thkaratsis/Mitsos----An-Open-Source-AI-Humanoid-Robot/README.md

**This repository will showcase the development of a small Ai Humanoid Robot**
