thkaratsis/Mitsos----An-Open-Source-AI-Humanoid-Robot/schemes/Readme.md

# Folder Overview

| Folder | Description |
|---|---|
| **Power Management** | Battery pack, BMS, fuse, power switch, voltage regulators, and power distribution throughout the robot. |
| **Controllers** | Raspberry Pi 5, ESP32-S3, processor communication, and overall system architecture. |
| **Sensors - Main Body** | IMU, Time-of-Flight sensors, PCA9685 servo controllers, camera interface, and communication buses located in the robot's main body. |
| **Sensors - Head** | Head electronics including the TFT display, MEMS microphone, audio amplifier, ribbon cable interface, and camera ring light connection. |
| **Camera RingLight** | Dedicated LED illumination PCB mounted around the camera to provide consistent lighting for computer vision tasks. |

# Documentation

Every hardware subfolder includes:

- Electrical schematic
- Hardware overview
- Communication architecture
- Component specifications
- Design considerations
- Mermaid block diagrams
