thkaratsis/Mitsos----An-Open-Source-AI-Humanoid-Robot/models/Legs/README.md

## Leg STL Files

| Part | Role | Material | File |
|---|---|---|---|
| FootBase2.1 | Outer foot base that screws onto the foot core and increases traction. | TPU | [FootBase2.1.stl](./FootBase2.1.stl) |
| FootCore1.1 | Main foot structure with holes for connecting the rest of the leg assembly. | PETG | [FootCore1.1.stl](./FootCore1.1.stl) |
| FootScrewBase1.2 | Weighted foot base with built-in screw mounts for up to 12 M20 nuts, lowering the center of mass. | PETG | [FootScrewBase1.2.stl](./FootScrewBase1.2.stl) |
| Gear-joint | Connects Leg2 to Leg1 and screws into a 25T servo horn for knee motion. | PETG | [Gear-joint.stl](./Gear-joint.stl) |
| Knee-AnkleBracket | Bracket that connects the knee/ankle servo assembly into the foot core. | ASA | [Knee-AnkleBracket.stl](./Knee-AnkleBracket.stl) |
| Leg1 | Base for the knee and ankle assembly, connects to the hip servo at the top. | PETG | [Leg1.stl](./Leg1.stl) |
| Leg2 | Base for the ankle servo. | PETG | [Leg2.stl](./Leg2.stl) |
| LegJointConnectors | Cylindrical connectors that hold the leg structure together and define the knee motion range.. | PETG | [LegJointConnectors.stl](./LegJointConnectors.stl) |
| LegJointStabilizer4 | Spring-loaded stabilizers used on both legs to keep the legs straight and prevent bending outward. | PETG | [LegJointStabilizer4.stl](./LegJointStabilizer4.stl) |
| LegMount | Bracket that holds the hip servo and connects the pelvis servo to the full leg assembly. | ASA | [LegMount.stl](./LegMount.stl) |
