thkaratsis/Mitsos----An-Open-Source-AI-Humanoid-Robot/models/Body/README.md

## Body STL Files

| Part | Role | Material | File |
|---|---|---|---|
| Body1.2 | Connects the head and shoulder servos | ASA | [Body1.2.stl](./Body1.2.stl) |
| Body2.1 | Rear connector between Body1.2 and Body3.3; holds the back TOF on the outside | PETG | [Body2.1.stl](./Body2.1.stl) |
| Body3.3 | Connects the pelvis servos and provides screw mounts for the main electronics board | PETG | [Body3.3.stl](./Body3.3.stl) |
| Body4.3 | Main structural body part, connects to all other body parts and holds the electronics, accessories, and front ToF sensors | PETG | [Body4.3.stl](./Body4.3.stl) |
| Body5.1 | Decorative cover part that screws over Body3.3 | PETG | [Body5.1.stl](./Body5.1.stl) |
| Body6.1 | Top body section that screws onto Body1.2, connects to the head, and includes a hole for the camera CSI cable | ASA | [Body6.1.stl](./Body6.1.stl) |
| BodyPiBase | Mounting base for the Raspberry Pi | ASA | [BodyPiBase.stl](./BodyPiBase.stl) |
| BodyTofBase | Mounting base for the front ToF sensors | PETG | [BodyTofBase.stl](./BodyTofBase.stl) |
| BodyV4Aceesss3 | Accessory that allow the user to effortlessly change the batteries | PETG | [BodyV4Aceesss3.stl](./BodyV4Aceesss3.stl) |
