thkaratsis/Mitsos----An-Open-Source-AI-Humanoid-Robot/schemes/Controllers/README.md

# Controllers 

<p align="center">
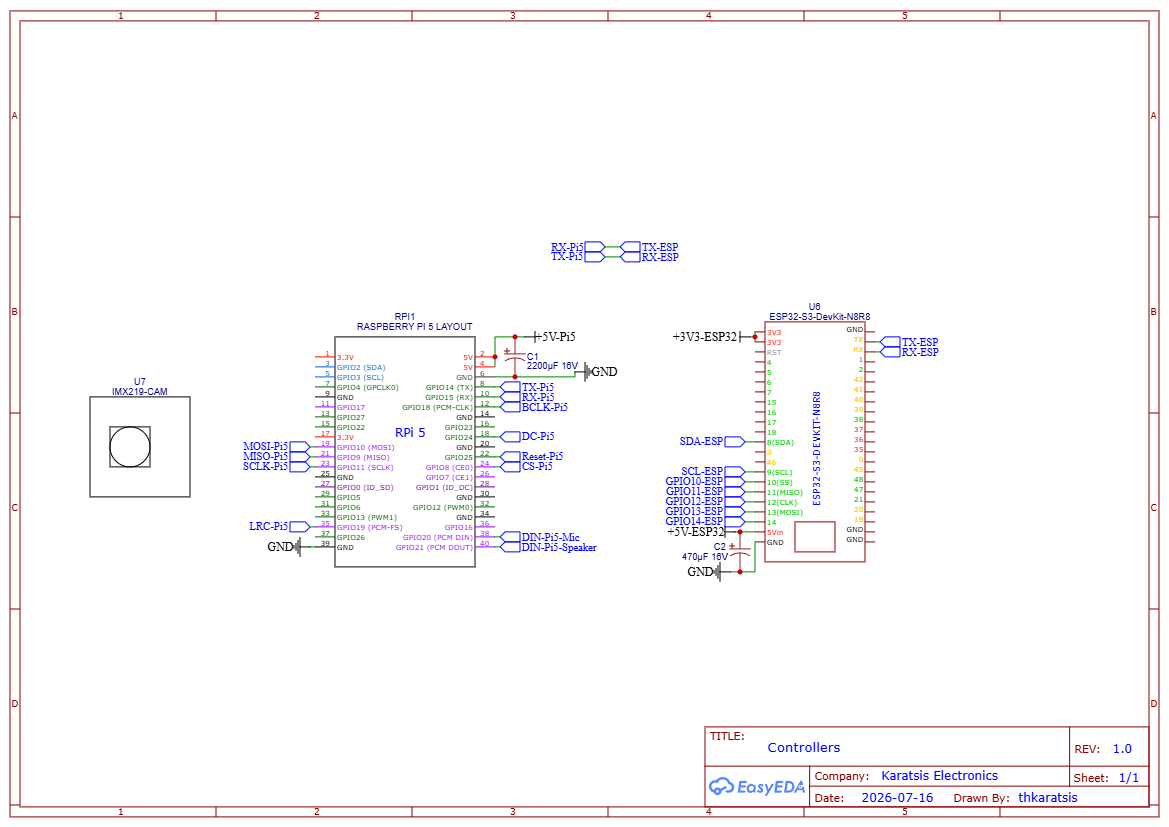
[picture p8: schemes/Controllers/Controllers.png]
  
</p>

<p align="center">
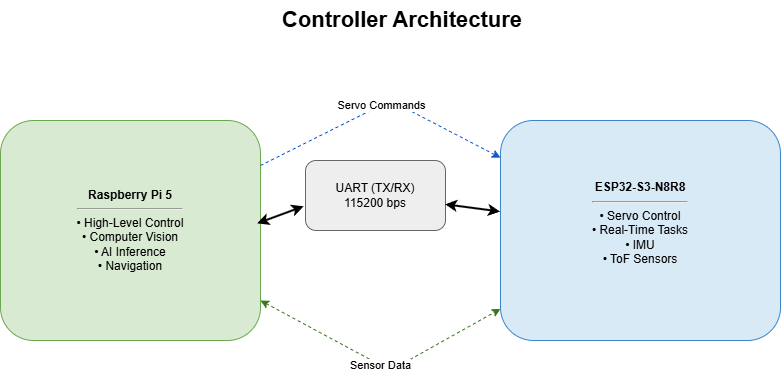
[picture p9: schemes/Controllers/Controllers_Diagram.drawio.png]
  
</p>

The robot's main controller is the **Raspberry Pi 5**, a powerful single-board computer (SBC) responsible for high-level control, computer vision, and AI inference. An **ESP32-S3-N8R8** microcontroller is used alongside the Raspberry Pi to accurate controll and gather data from all of the sensors.

To ensure reliable communication between the two processing units, the **Raspberry Pi 5** and the **ESP32-S3-N8R8** exchange data over a **full-duplex UART interface**. This bidirectional communication enables simultaneous transmission and reception of commands and sensor data.

The **Raspberry Pi 5** performs the high-level control tasks, generating servo commands and transmitting them to the ESP32. The **ESP32**, acting as the real-time controller, executes these commands while continuously collecting data from all onboard sensors and transmitting the measurements back to the Raspberry Pi.This set up allows the Raspberry Pi to focus on AI and navigation while the ESP32 handles real-time hardware interaction.

## Raspberry Pi 5

| Specification | Value |
|---|---|
| Processor | Broadcom BCM2712 |
| CPU Architecture | 64-bit Arm Cortex-A76 |
| CPU Cores | 4 |
| CPU Frequency | Up to 2.4 GHz |
| Memory | 16 GB LPDDR4X SDRAM |
| GPU | VideoCore VII |
| AI Acceleration | Software (CPU/GPU) |
| Storage | microSD Card |
| Wireless | Wi-Fi 802.11ac, Bluetooth 5.0 BLE |
| Ethernet | Gigabit Ethernet |
| USB | 2 × USB 3.0, 2 × USB 2.0 |
| Camera Interface | 2 × MIPI CSI |
| Display Interface | 2 × MIPI DSI |
| GPIO | 40-pin Header |
| UART | Yes |
| Operating Voltage | 5 V DC |
| Typical Power Consumption | 3–12 W | 

## ESP32-S3-N8R8

| Specification | Value |
|---|---|
| Processor | Xtensa® LX7 Dual-Core |
| CPU Frequency | Up to 240 MHz |
| CPU Cores | 2 |
| SRAM | 512 KB |
| Flash Memory | 8 MB |
| PSRAM | 8 MB |
| Wi-Fi | 2.4 GHz IEEE 802.11 b/g/n |
| Bluetooth | Bluetooth 5 LE |
| GPIO | Up to 45 |
| ADC | 20 Channels (12-bit) |
| SPI | Yes |
| I²C | Yes |
| UART | 3 Controllers |
| PWM | LEDC PWM |
| USB | Native USB OTG |
| Operating Voltage | 3.0–3.6 V |
| Typical Current Consumption | ~80–240 mA (application dependent) |
