thkaratsis/Mitsos----An-Open-Source-AI-Humanoid-Robot/Mechanical Analysis/COM - Center Of Mass/FrontView.png

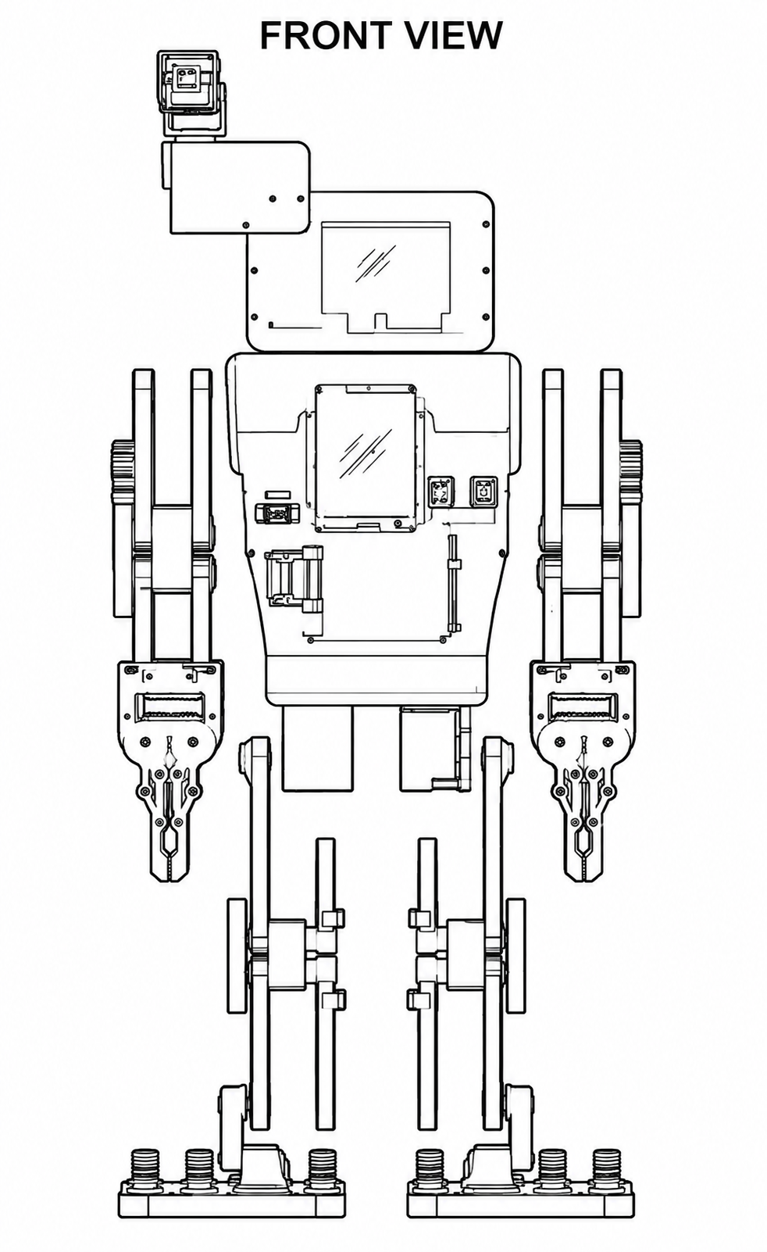
Mechanical Analysis/COM - Center Of Mass/FrontView.png
