thkaratsis/Mitsos----An-Open-Source-AI-Humanoid-Robot/models/ArmFull.stl

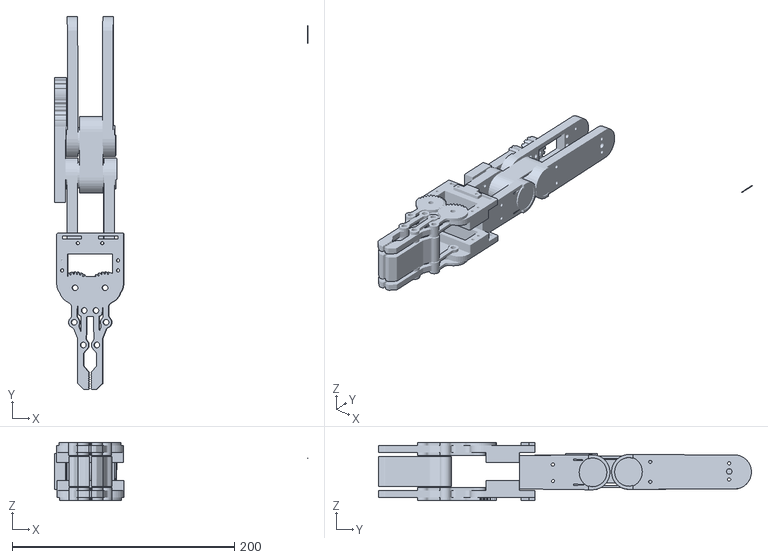
[picture p12: CAD file, 2026-07-18]
models/ArmFull.stl
227.7 x 335.5 x 52.4
