thkaratsis/Mitsos----An-Open-Source-AI-Humanoid-Robot/models/HeadFull.stl

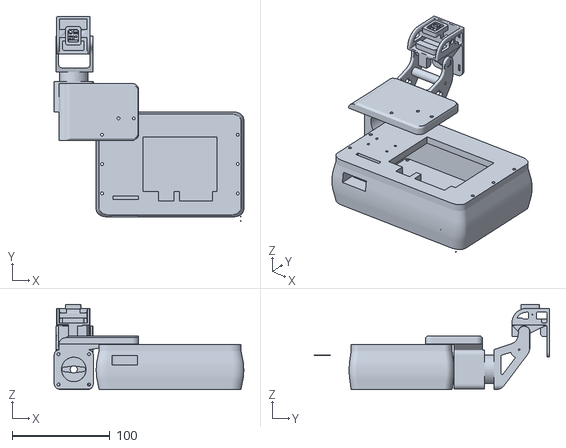
[picture p13: CAD file, 2026-07-18]
models/HeadFull.stl
193.9 x 240.4 x 87.0
