thkaratsis/Mitsos----An-Open-Source-AI-Humanoid-Robot/models/Arms/ServoGripperGear.stl

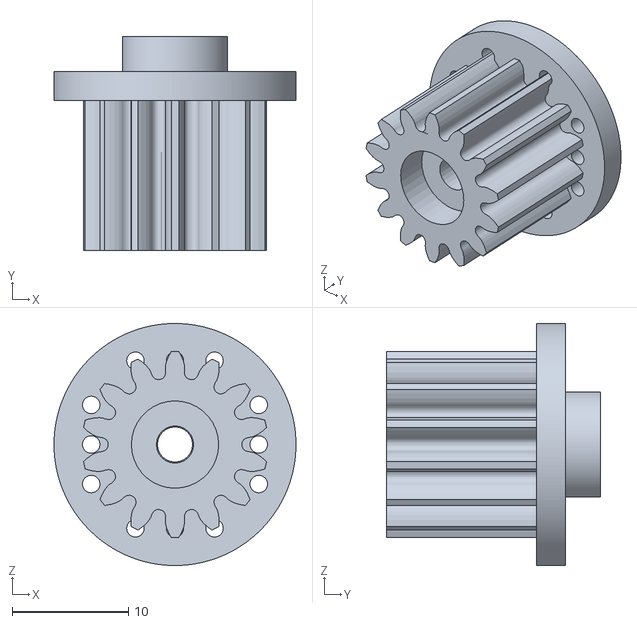
[picture p14: CAD file, 2026-07-18]
models/Arms/ServoGripperGear.stl
20.8 x 18.4 x 20.8
