thkaratsis/Mitsos----An-Open-Source-AI-Humanoid-Robot/models/Body/Body1.2.stl

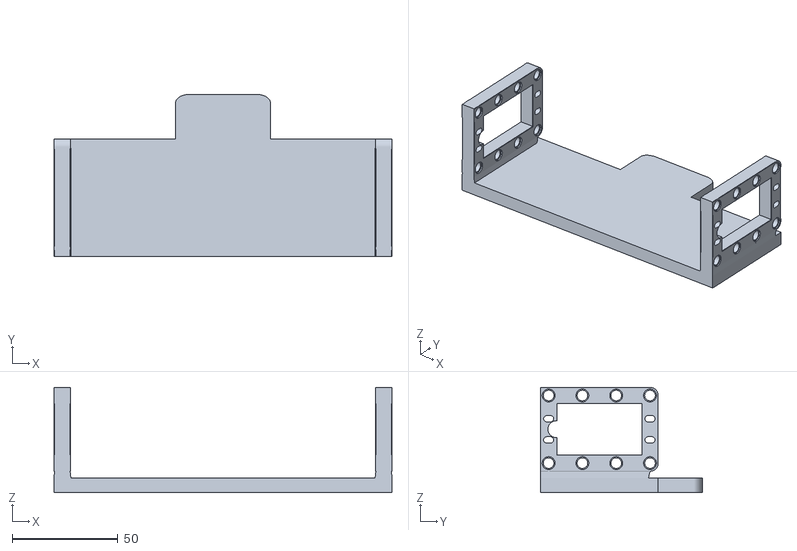
[picture p15: CAD file, 2026-07-18]
models/Body/Body1.2.stl
160.0 x 76.8 x 49.9
