thkaratsis/Mitsos----An-Open-Source-AI-Humanoid-Robot/models/Head/Head5.stl

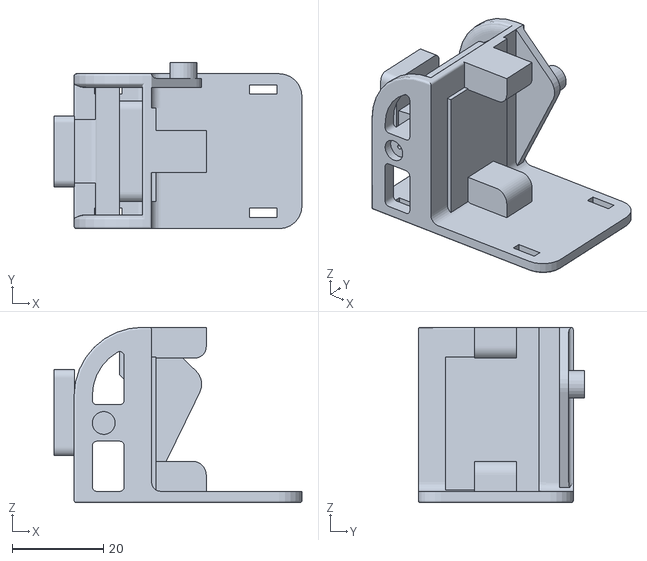
[picture p16: CAD file, 2026-07-18]
models/Head/Head5.stl
54.4 x 36.5 x 38.5
