thkaratsis/Mitsos----An-Open-Source-AI-Humanoid-Robot/models/Legs/Gear-joint.stl

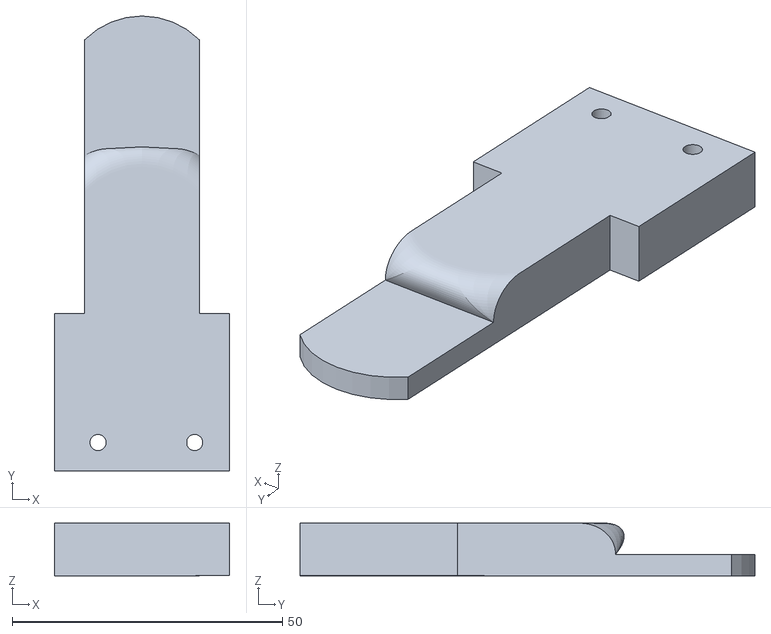
[picture p17: CAD file, 2026-07-18]
models/Legs/Gear-joint.stl
32.5 x 84.2 x 9.76
