thkaratsis/Mitsos----An-Open-Source-AI-Humanoid-Robot/models/Arms/Arm1.stl

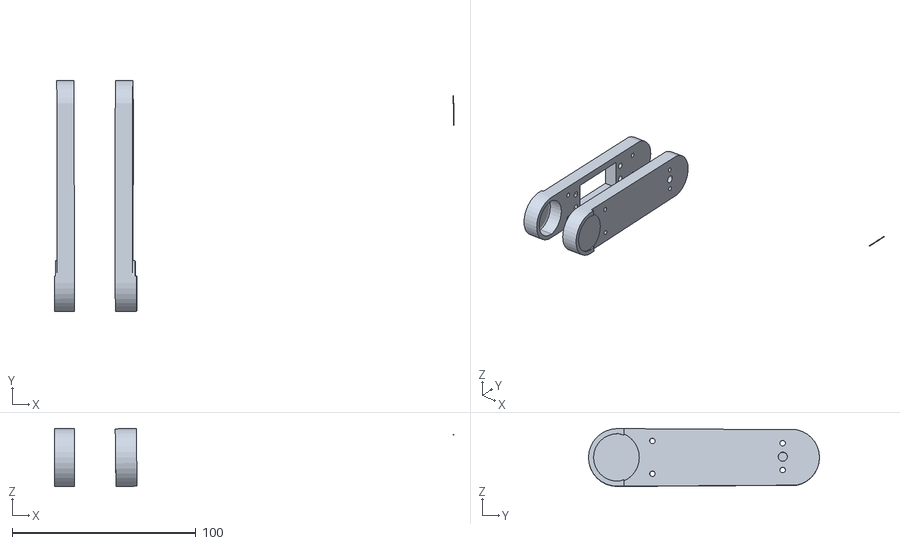
[picture p18: CAD file, 2026-07-18]
models/Arms/Arm1.stl
217.4 x 125.9 x 31.6
