thkaratsis/Mitsos----An-Open-Source-AI-Humanoid-Robot/models/Body/Body3.3.stl

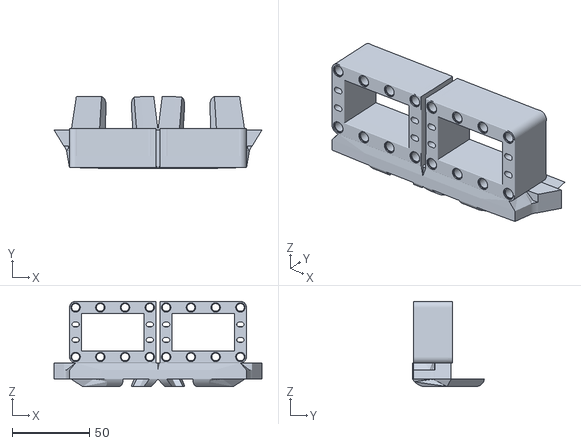
[picture p19: CAD file, 2026-07-18]
models/Body/Body3.3.stl
134.5 x 46.3 x 55.2
