thkaratsis/Mitsos----An-Open-Source-AI-Humanoid-Robot/models/Head/Head6.stl

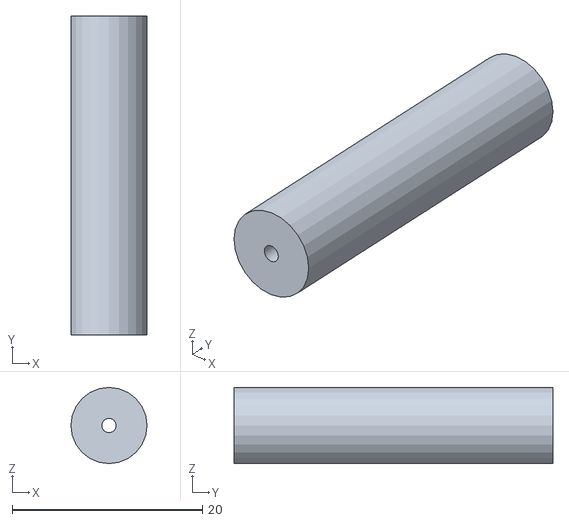
[picture p20: CAD file, 2026-07-18]
models/Head/Head6.stl
8.00 x 33.5 x 8.00
