thkaratsis/Mitsos----An-Open-Source-AI-Humanoid-Robot/models/Legs/FootCore1.1.stl

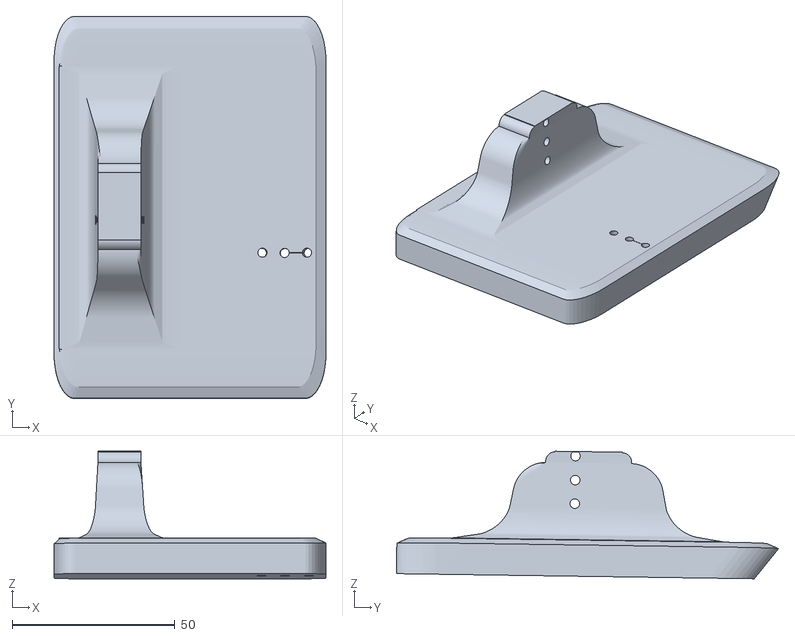
[picture p21: CAD file, 2026-07-18]
models/Legs/FootCore1.1.stl
83.6 x 117.5 x 39.2
