thkaratsis/Mitsos----An-Open-Source-AI-Humanoid-Robot/models/Arms/Arm2.stl

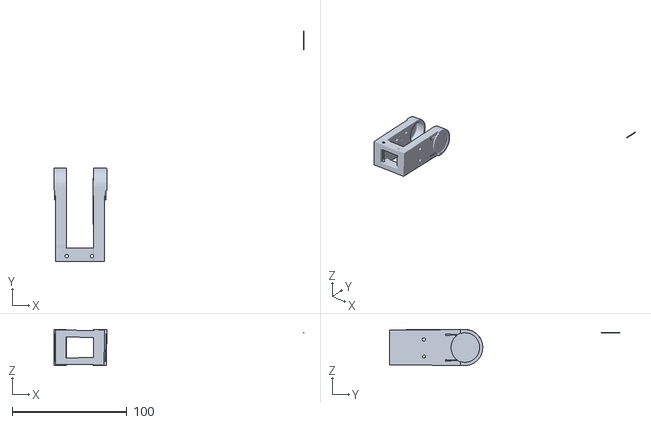
[picture p22: CAD file, 2026-07-18]
models/Arms/Arm2.stl
217.5 x 200.5 x 31.6
