thkaratsis/Mitsos----An-Open-Source-AI-Humanoid-Robot/models/Body/Body6.1.stl

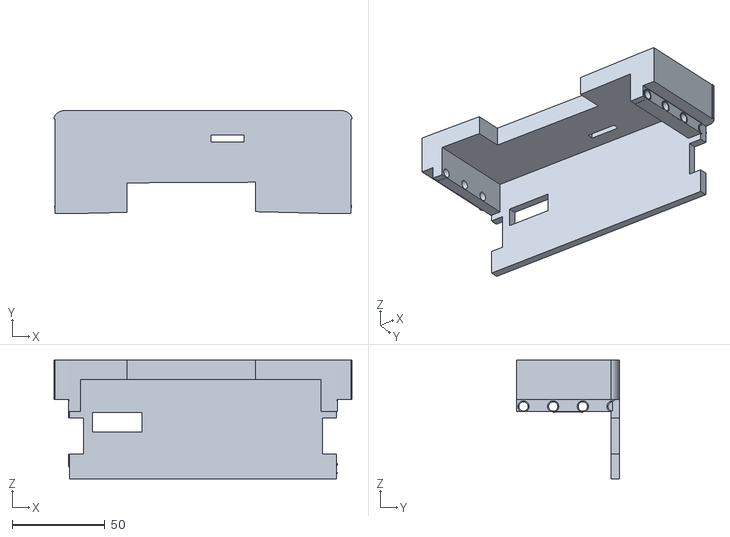
[picture p23: CAD file, 2026-07-18]
models/Body/Body6.1.stl
160.6 x 55.8 x 64.0
