thkaratsis/Mitsos----An-Open-Source-AI-Humanoid-Robot/models/Head/Head2.stl

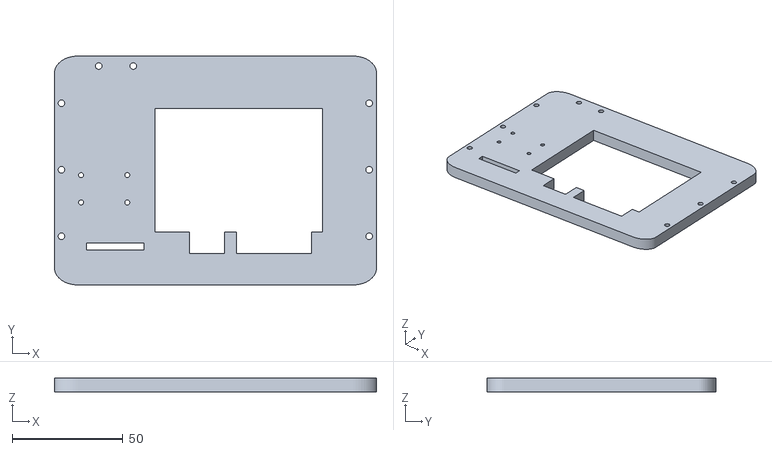
[picture p24: CAD file, 2026-07-18]
models/Head/Head2.stl
145.2 x 103.3 x 6.47
