thkaratsis/Mitsos----An-Open-Source-AI-Humanoid-Robot/models/Arms/ArmGripper.stl

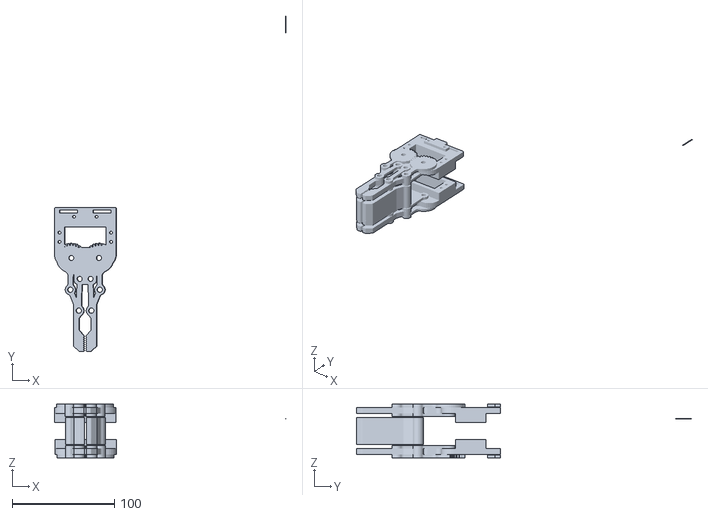
[picture p25: CAD file, 2026-07-18]
models/Arms/ArmGripper.stl
225.4 x 327.3 x 52.4
