thkaratsis/Mitsos----An-Open-Source-AI-Humanoid-Robot/models/Body/Body4.3.stl

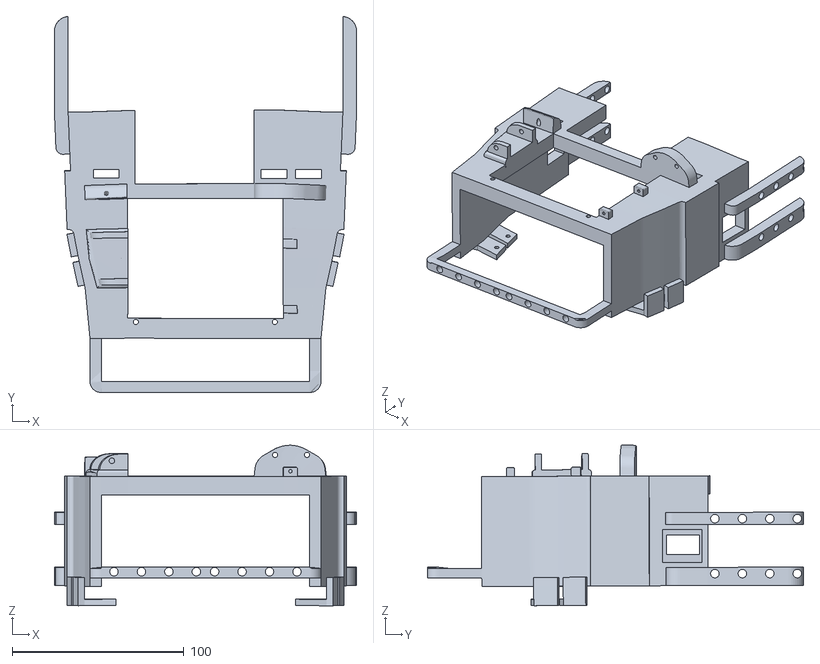
[picture p26: CAD file, 2026-07-18]
models/Body/Body4.3.stl
175.9 x 218.9 x 93.5
