thkaratsis/Mitsos----An-Open-Source-AI-Humanoid-Robot/models/Head/Head1.stl

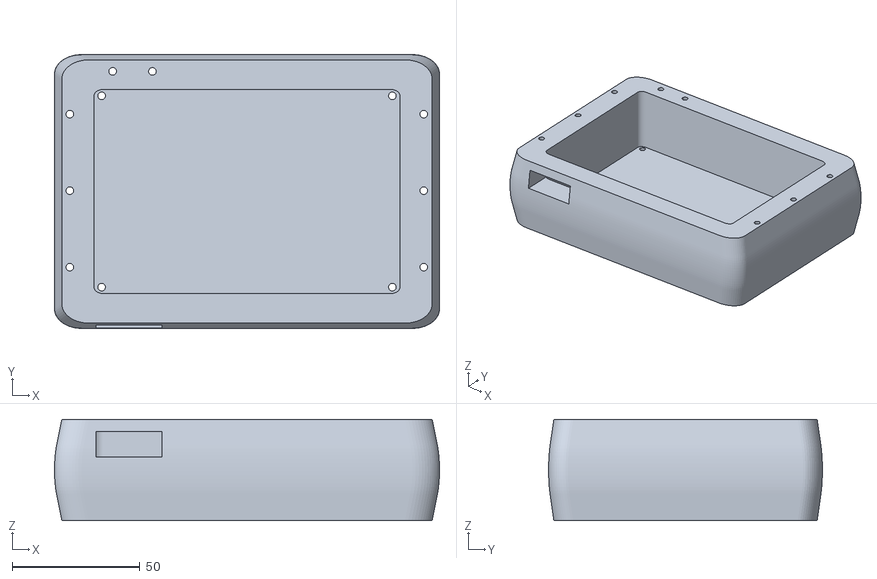
[picture p27: CAD file, 2026-07-18]
models/Head/Head1.stl
151.0 x 107.3 x 39.7
