thkaratsis/Mitsos----An-Open-Source-AI-Humanoid-Robot/models/Legs/LegJointStabilizer4.stl

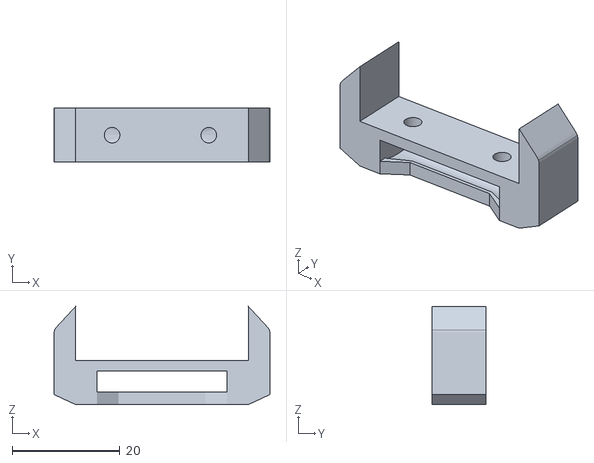
[picture p28: CAD file, 2026-07-18]
models/Legs/LegJointStabilizer4.stl
40.0 x 10.0 x 18.2
