thkaratsis/Mitsos----An-Open-Source-AI-Humanoid-Robot/models/Arms/ArmGears.stl

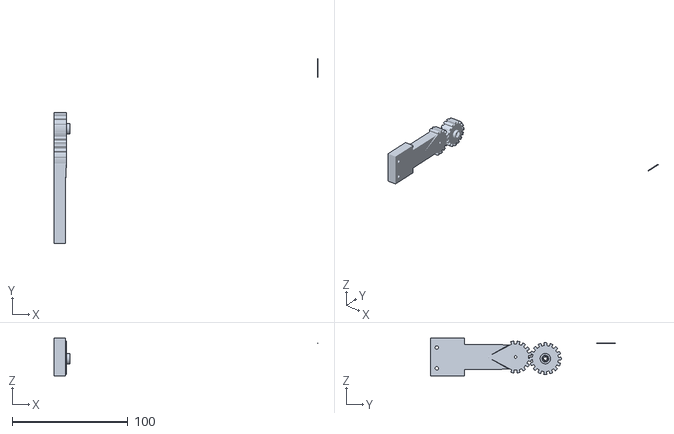
[picture p29: CAD file, 2026-07-18]
models/Arms/ArmGears.stl
227.7 x 159.2 x 32.5
