thkaratsis/Mitsos----An-Open-Source-AI-Humanoid-Robot/models/Body/BodyTofBase.stl

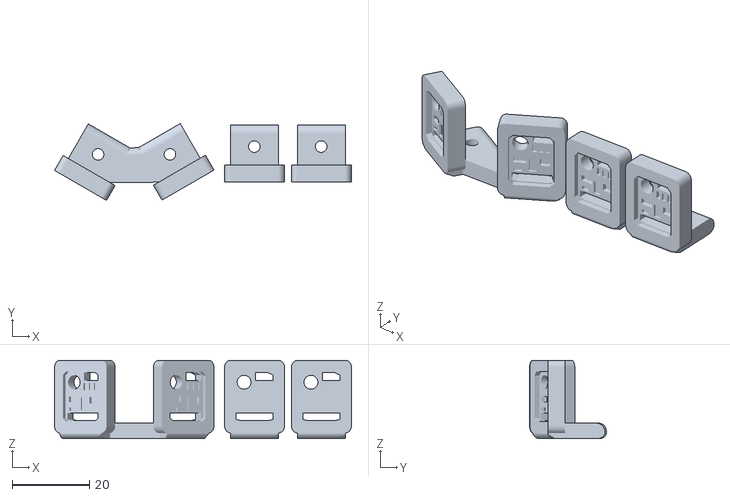
[picture p30: CAD file, 2026-07-18]
models/Body/BodyTofBase.stl
76.9 x 19.9 x 20.3
