thkaratsis/Mitsos----An-Open-Source-AI-Humanoid-Robot/models/Head/Head3.stl

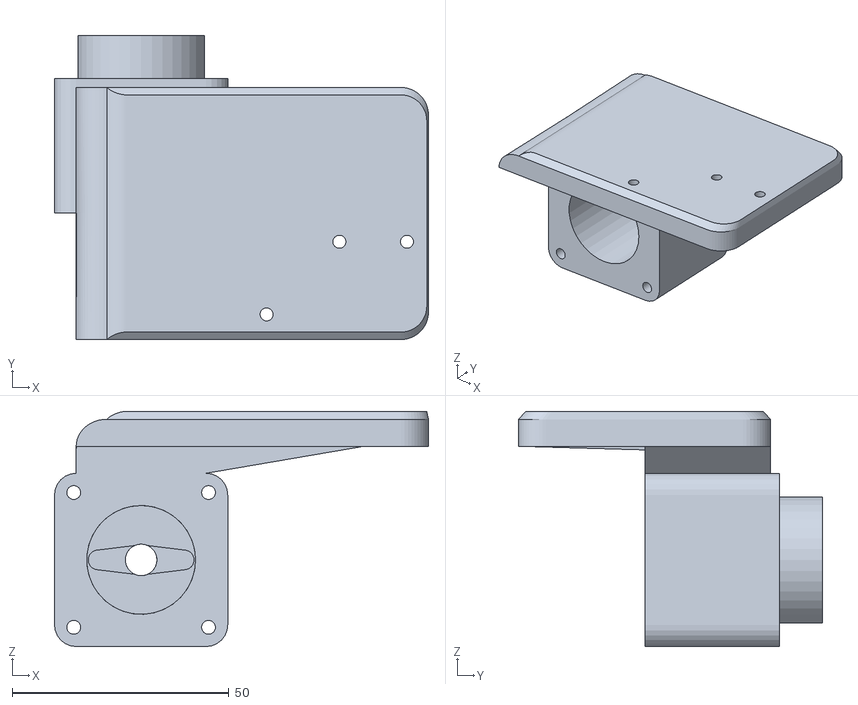
[picture p31: CAD file, 2026-07-18]
models/Head/Head3.stl
86.3 x 70.2 x 54.3
