thkaratsis/Mitsos----An-Open-Source-AI-Humanoid-Robot/models/Legs/Knee-AnkleBracket.stl

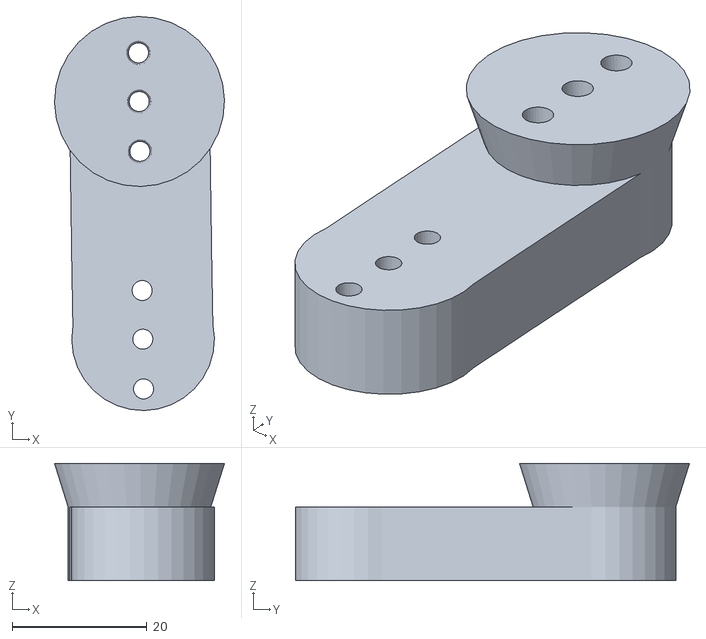
[picture p32: CAD file, 2026-07-18]
models/Legs/Knee-AnkleBracket.stl
25.2 x 58.5 x 17.4
