thkaratsis/Mitsos----An-Open-Source-AI-Humanoid-Robot/models/Body/BodyV4Aceesss3.stl

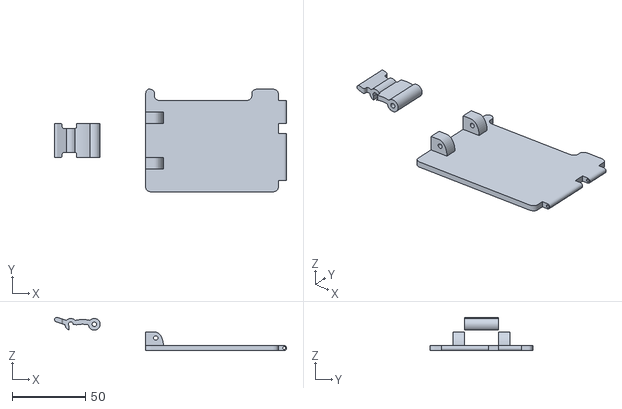
[picture p33: CAD file, 2026-07-18]
models/Body/BodyV4Aceesss3.stl
157.8 x 69.9 x 22.8
