thkaratsis/Mitsos----An-Open-Source-AI-Humanoid-Robot/models/Head/Head4.stl

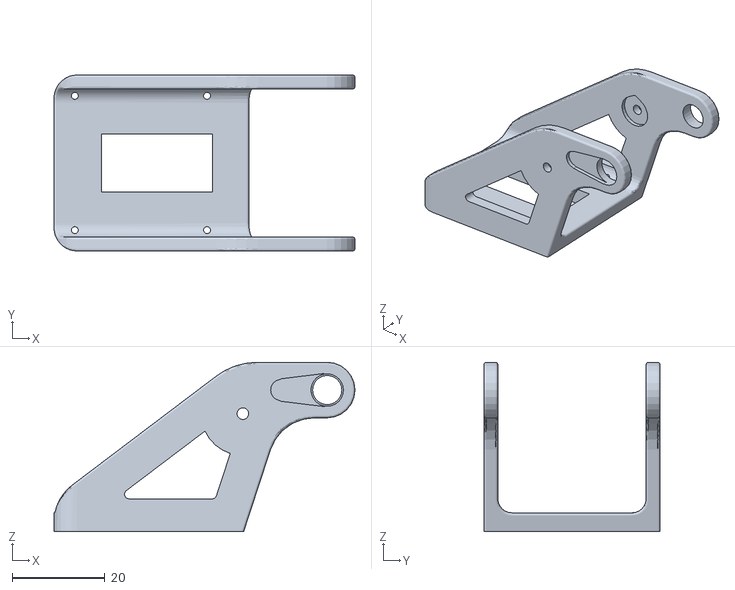
[picture p34: CAD file, 2026-07-18]
models/Head/Head4.stl
65.0 x 38.0 x 36.6
