thkaratsis/Mitsos----An-Open-Source-AI-Humanoid-Robot/models/Legs/Leg1.stl

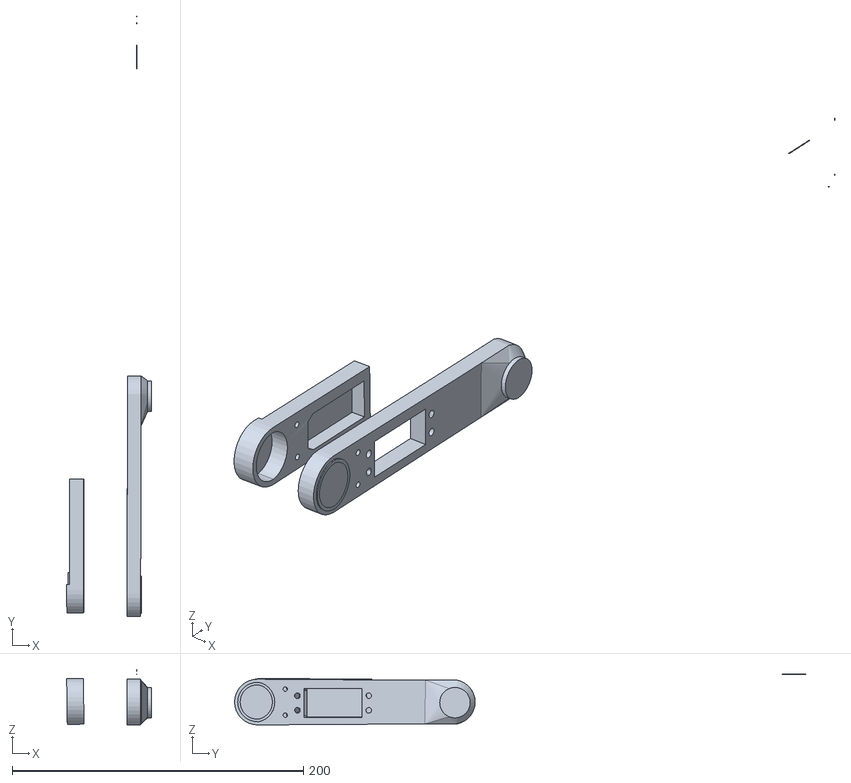
[picture p35: CAD file, 2026-07-18]
models/Legs/Leg1.stl
58.2 x 412.3 x 38.4
