thkaratsis/Mitsos----An-Open-Source-AI-Humanoid-Robot/models/Body/BodyPiBase.stl

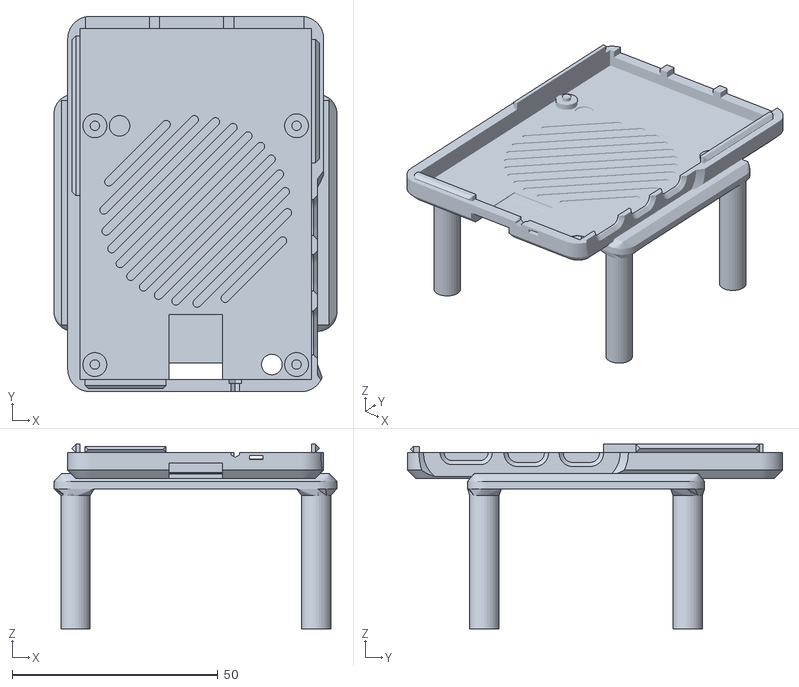
[picture p36: CAD file, 2026-07-18]
models/Body/BodyPiBase.stl
68.8 x 91.2 x 44.8
