thkaratsis/Mitsos----An-Open-Source-AI-Humanoid-Robot/models/Legs/LegMount.stl

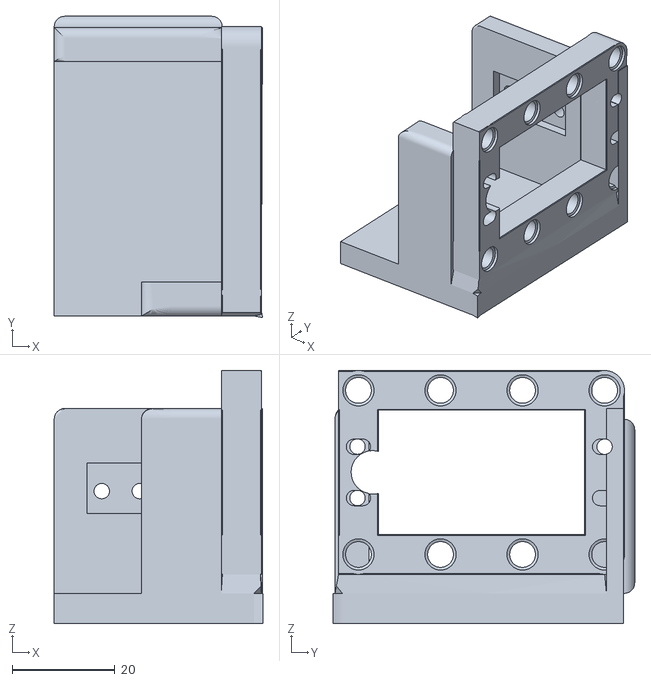
[picture p37: CAD file, 2026-07-18]
models/Legs/LegMount.stl
40.7 x 58.8 x 49.3
