thkaratsis/Mitsos----An-Open-Source-AI-Humanoid-Robot/models/Body/Body5.1.stl

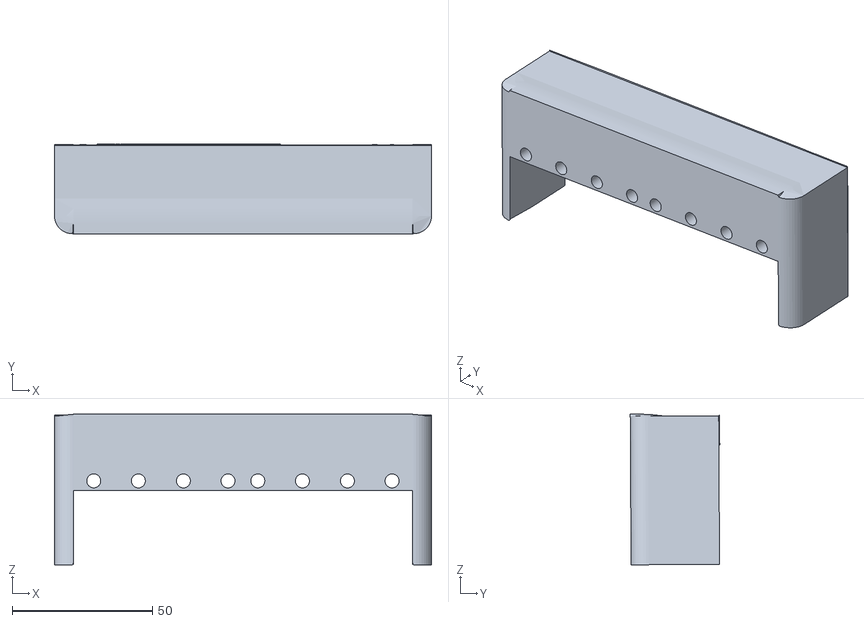
[picture p38: CAD file, 2026-07-18]
models/Body/Body5.1.stl
134.5 x 31.9 x 53.7
