thkaratsis/Mitsos----An-Open-Source-AI-Humanoid-Robot/models/Legs/Leg2.stl

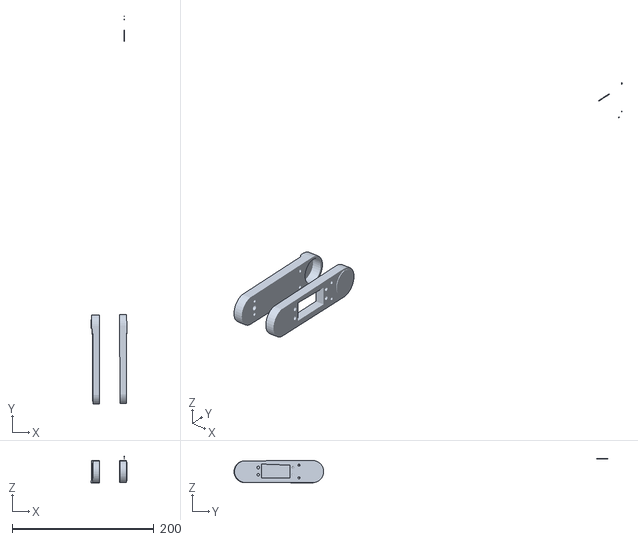
[picture p39: CAD file, 2026-07-18]
models/Legs/Leg2.stl
50.2 x 547.8 x 37.8
