thkaratsis/Mitsos----An-Open-Source-AI-Humanoid-Robot/models/Body/Body2.1.stl

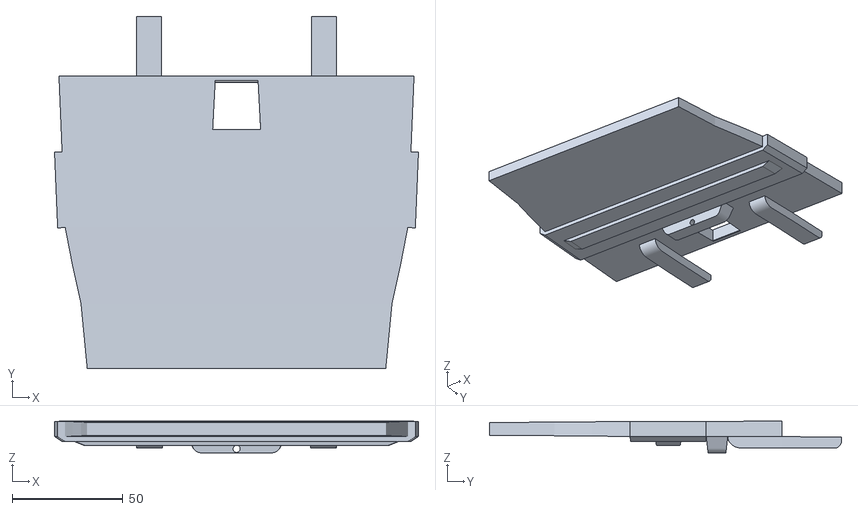
[picture p40: CAD file, 2026-07-18]
models/Body/Body2.1.stl
164.0 x 158.7 x 14.3
