thkaratsis/Mitsos----An-Open-Source-AI-Humanoid-Robot/models/Legs/FootBase2.1.stl

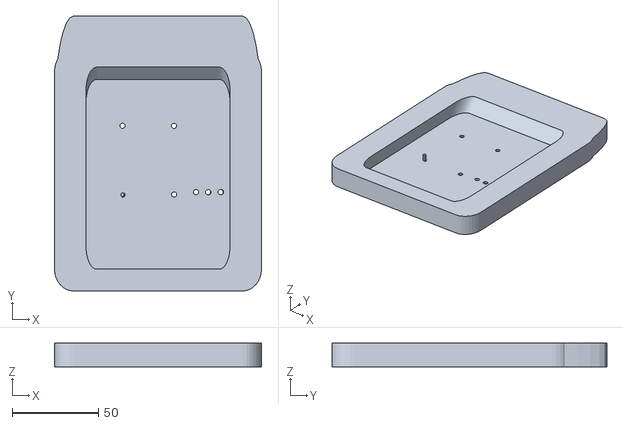
[picture p41: CAD file, 2026-07-18]
models/Legs/FootBase2.1.stl
120.0 x 159.4 x 13.7
