thkaratsis/Mitsos----An-Open-Source-AI-Humanoid-Robot/models/Legs/LegJointConnectors.stl

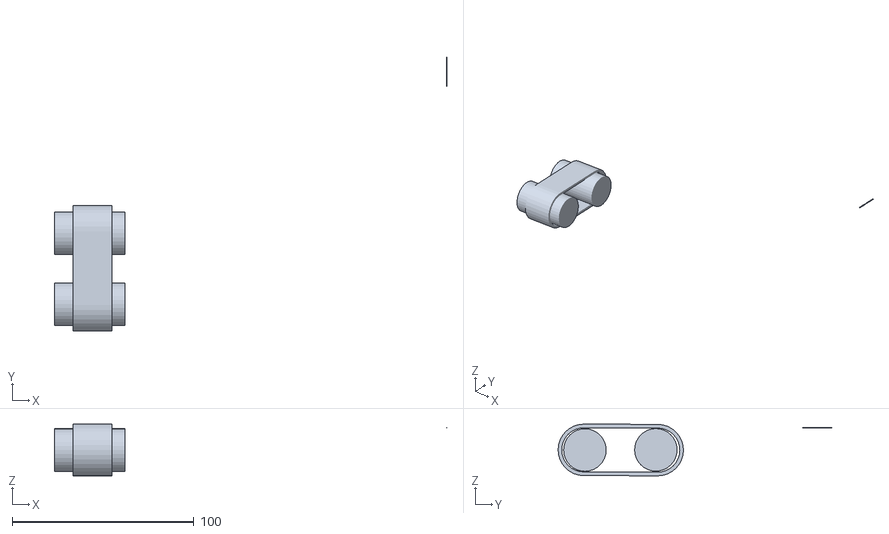
[picture p42: CAD file, 2026-07-18]
models/Legs/LegJointConnectors.stl
215.4 x 150.5 x 28.4
