thkaratsis/Mitsos----An-Open-Source-AI-Humanoid-Robot/(list of files, cad)

Other CAD files:
models/Legs/FootScrewBase1.2.stl
