thkaratsis/Mitsos----An-Open-Source-AI-Humanoid-Robot/(commit log)

2026-07-17 Create Power_Management.md
2026-07-17 Revise Power Management documentation
    Updated the document to focus on power management details and removed sections about current consumption analysis.
2026-07-17 Enhance Power Management documentation with fuse details
    Added information about a 4A fuse and a switch for the robot.
2026-07-17 Enhance Power Management documentation with schematic
    Added an image and description for the power management schematic.
2026-07-17 Rename Sheet_1.png to Power Managment.png
2026-07-17 Update and rename Power_Management.md to README.md
2026-07-17 Rename Power Managment.png to Power Management.png
2026-07-17 Enhance README with power management details
    Added detailed description of the power management system and battery configuration.
2026-07-17 Rename Ανώνυμο διάγραμμα.drawio.png to Controllers_Diagram.drawio.png
2026-07-17 Rename Sheet_3.png to Sensor - Main Body.png
2026-07-17 Rename Sheet_4.png to Sensors - Head.png
2026-07-17 Update image source in Sensors Head README
